Anu2657/Menstrual-Tracker/PHOTOS/IMG_20261025_213342273.jpg

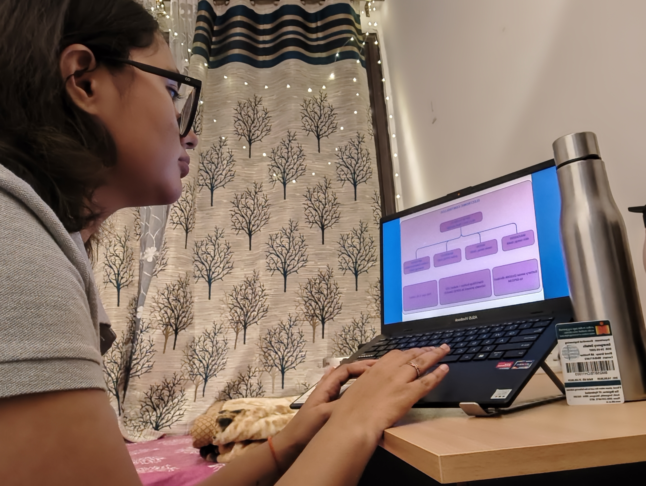
PHOTOS/IMG_20261025_213342273.jpg
