Anu2657/Menstrual-Tracker/README.md

# Menstrual-Tracker
Wearable device for menstrual cycle tracking-Vishwakarma Awards 26-27
