Anu2657/Menstrual-Tracker/PHOTOS/README.md

All pictures of work done including screenshots of the WIP CAD designing, (please include the places where difficulty is faced as well)
