Anu2657/Menstrual-Tracker/PHOTOS/Electronic Controller(1).png

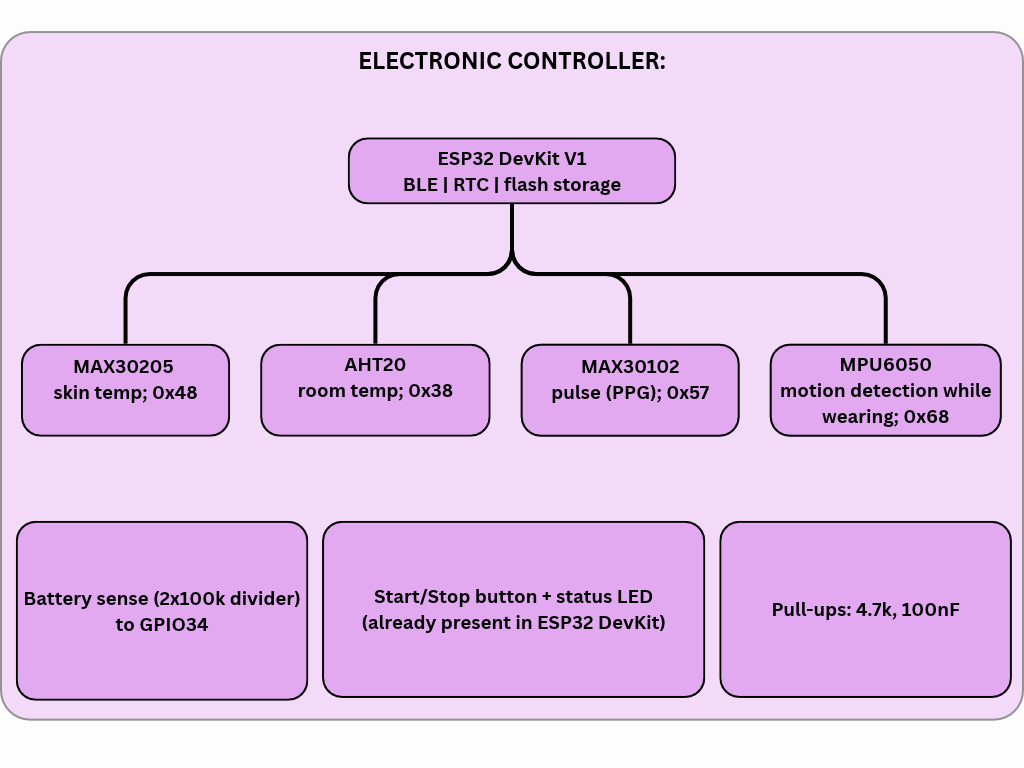
PHOTOS/Electronic Controller(1).png
