Anu2657/Menstrual-Tracker/PHOTOS/Labelled Exploded View .jpeg

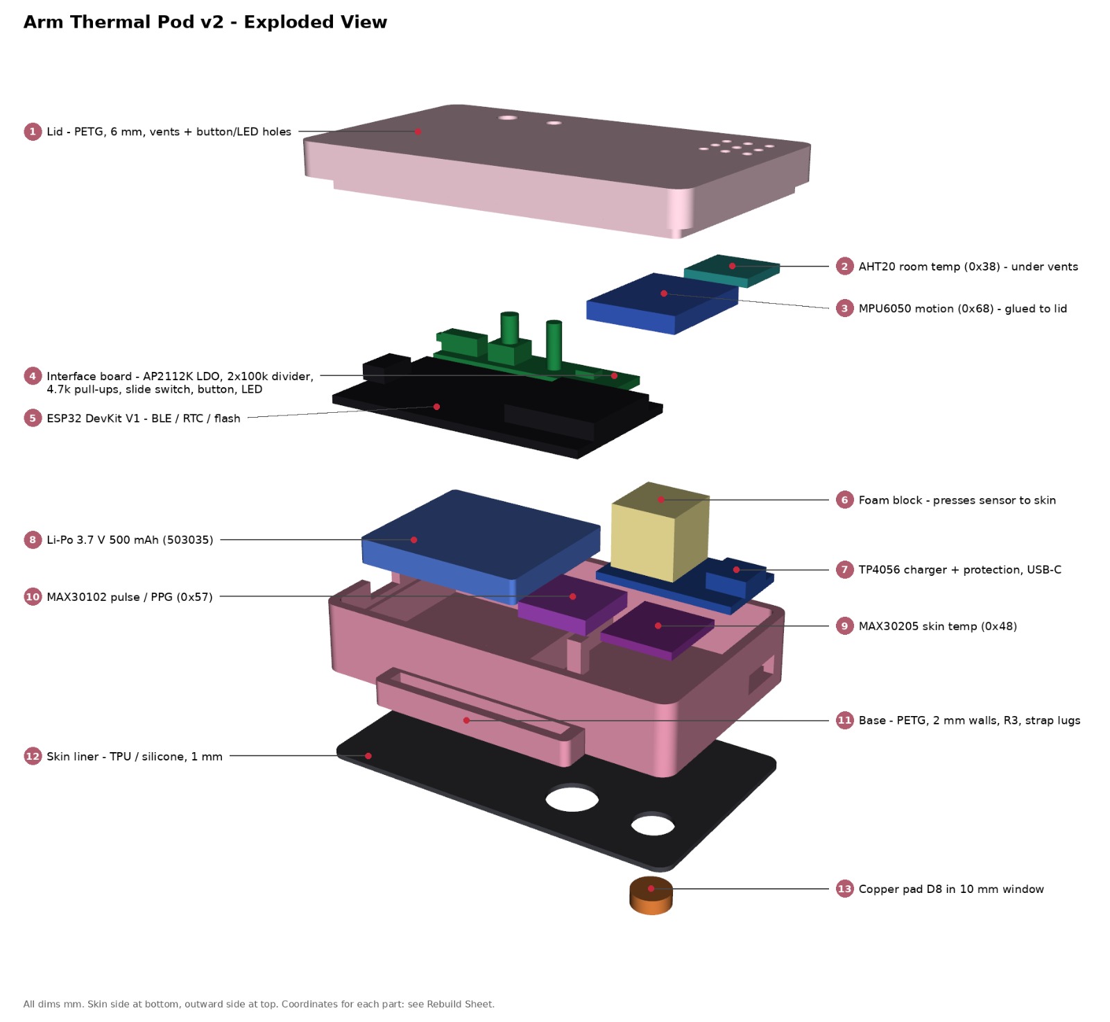
PHOTOS/Labelled Exploded View .jpeg
