Anu2657/Menstrual-Tracker/PHOTOS/Mechanical Structure(1).png

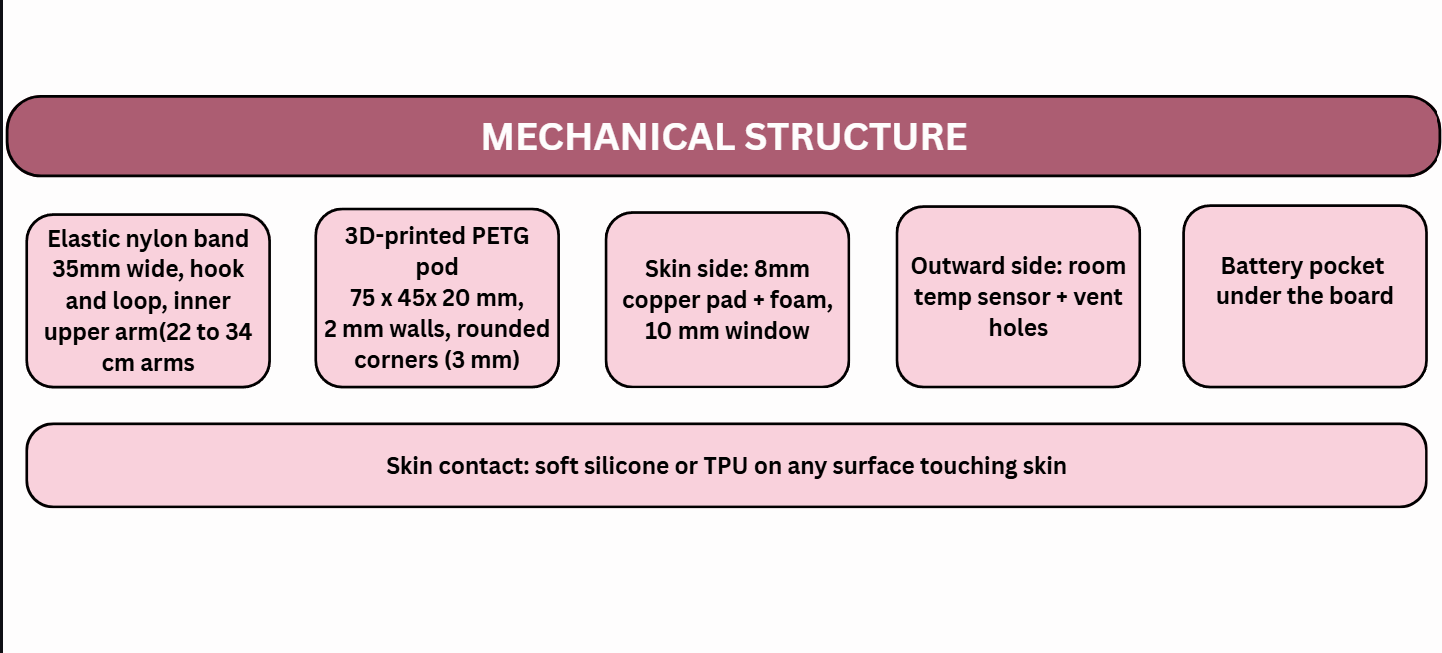
PHOTOS/Mechanical Structure(1).png
