Anu2657/Menstrual-Tracker/PHOTOS/Power.png

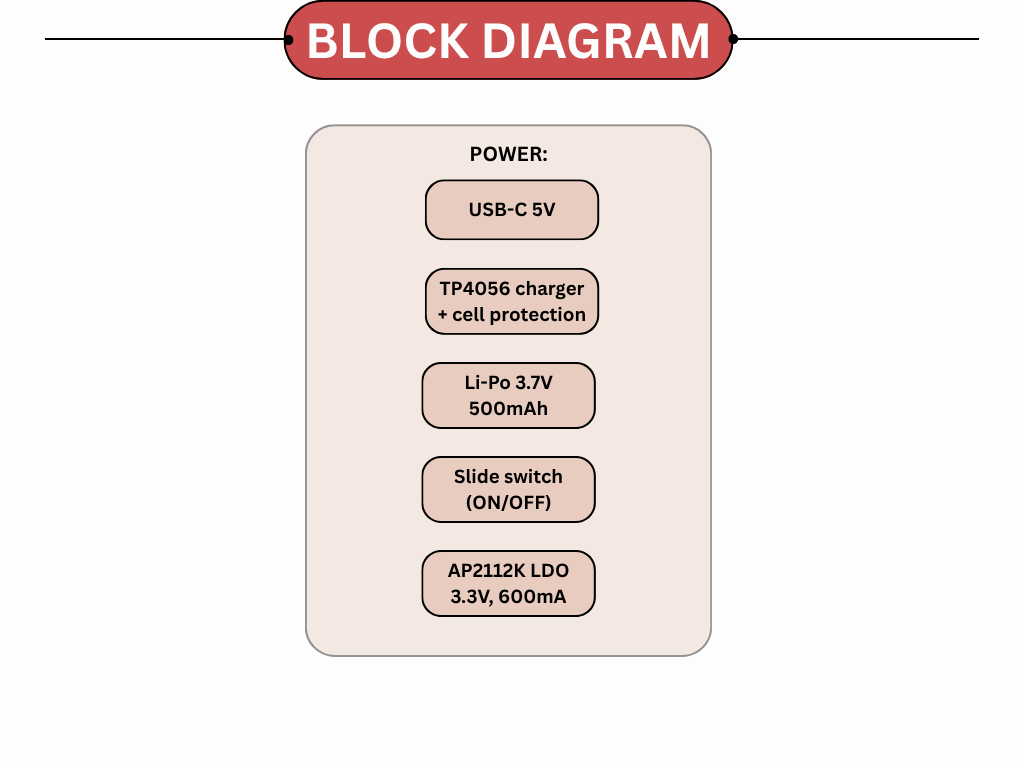
PHOTOS/Power.png
