Anu2657/Menstrual-Tracker/PHOTOS/Readings.png

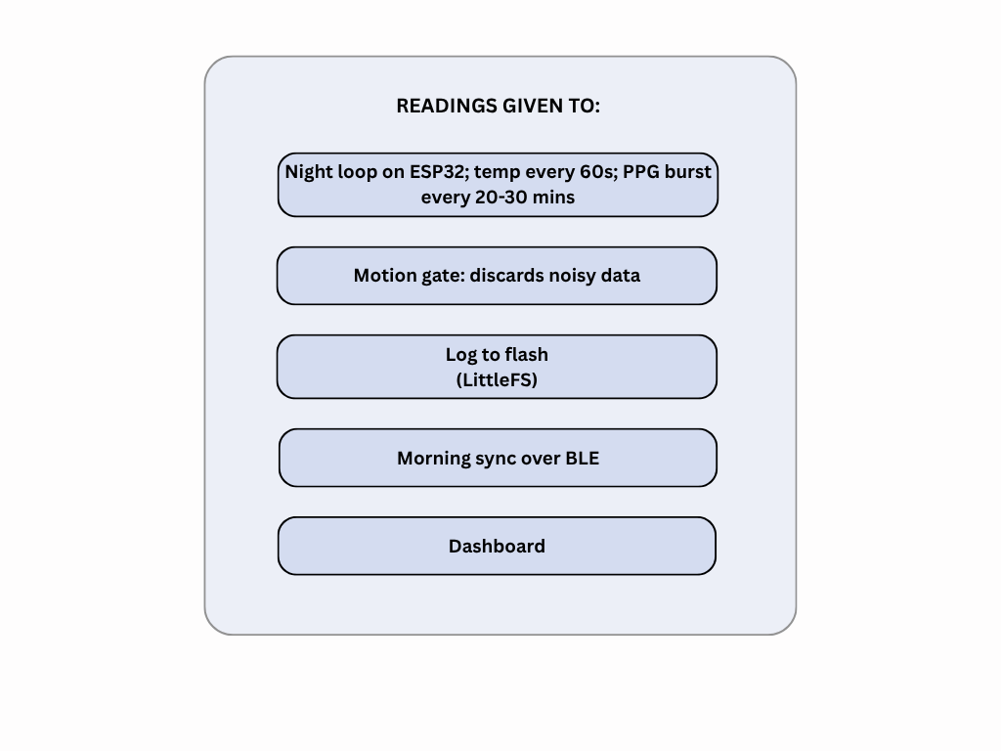
PHOTOS/Readings.png
