Anu2657/Menstrual-Tracker/SCHEMATICS/Block Diagram of Electric Schematic.png

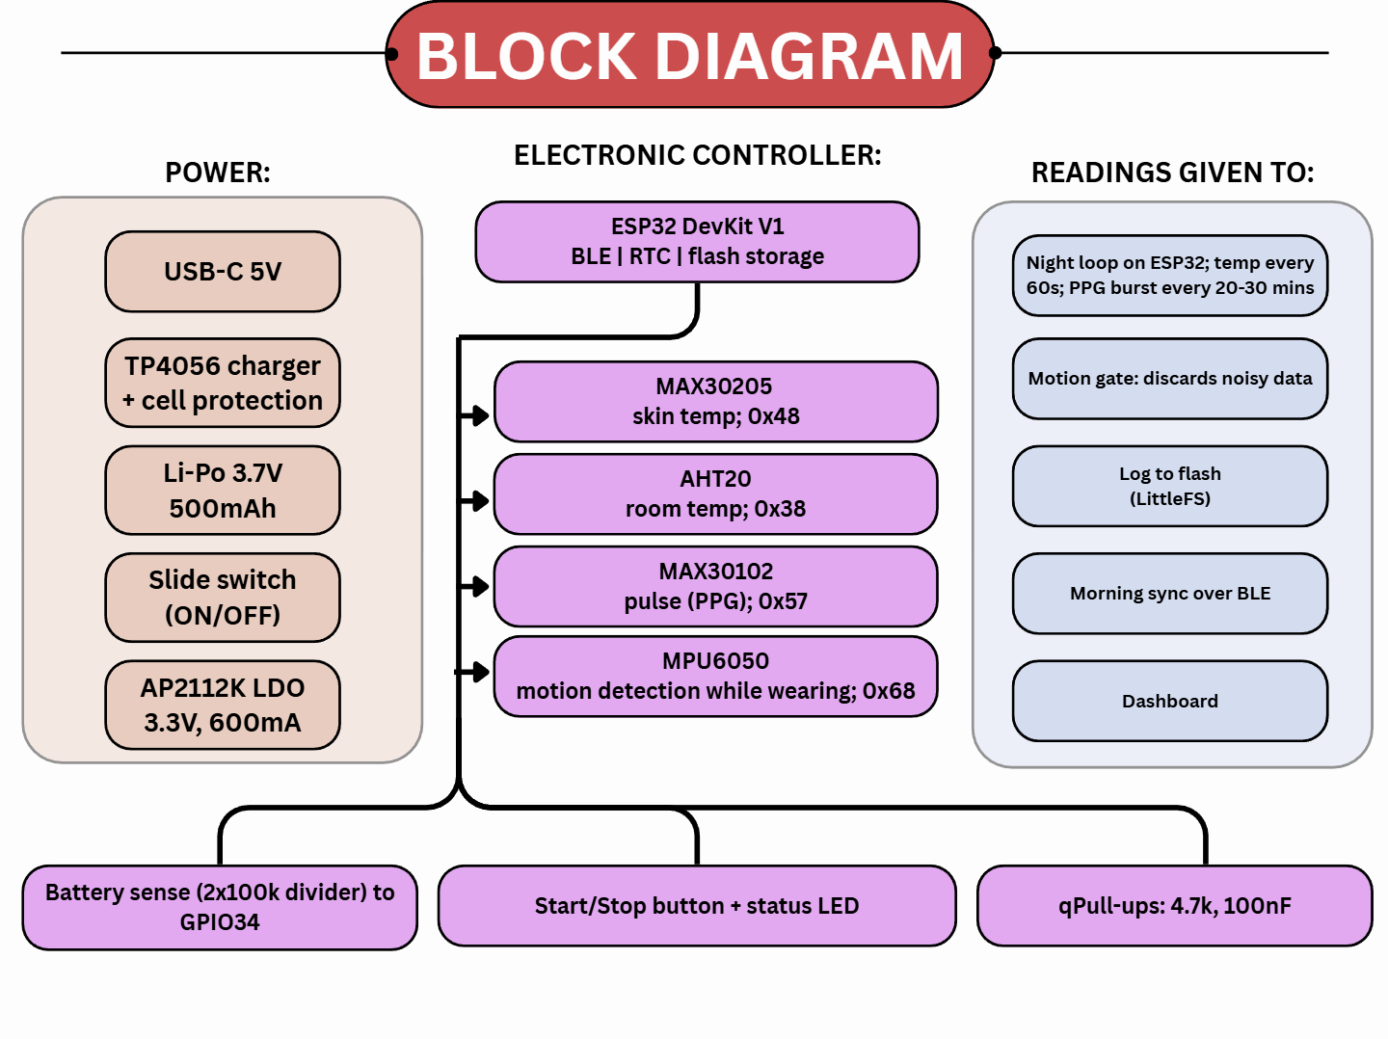
SCHEMATICS/Block Diagram of Electric Schematic.png
