Anu2657/Menstrual-Tracker/MATERIALS/README.md

Materials selection and mechanical specs to be uploaded here
