Anu2657/Menstrual-Tracker/MATERIALS/Specs and components.xlsx

Sheet: Target specs
Parameter | Target | Hardware
Logging | 8 h per night, at least 2 nights per charge (to verify) | 500 mAh LiPo
Skin temperature | 1 sample per minute, resolution 0.01 °C or better | MAX30205
Pulse bursts | 2 min every 20 to 30 min at 100 Hz | MAX30102
Motion and wear | 50 Hz accelerometer | MPU6050
Data per night | about 0.4 MB (16 bursts × 12,000 samples × 2 bytes, plus small logs) | ESP32 flash
Sync | Bluetooth each morning | ESP32
Mass | 80 g or less | Pod plus band

Sheet: Materials + Electrical componen
Component | Part | Qty | Must contain
Controller | ESP32 DevKit | 1 | Confirm it’s the classic ESP32-WROOM-32 based DevKit V1 (not an S2/S3/C3 variant) Has a USB port for programming (most do, but double-check it’s not a bare module requiring separate programming hardware)
Skin temp | MAX30205 module | 1 | Onboard pull-up resistors on SDA and SCL Onboard 0.1µF decoupling capacitor near the power pin A0/A1/A2 address pins clearly broken out or confirmed tied low (default address 0x49) Operates on 3.3V
Pulse | MAX30102 module | 1 | Onboard 1.8V regulator Onboard pull-up resistors on SDA/SCL (4.7kΩ typical) Important: confirm with the seller/listing that the pull-ups are wired to the module’s 3.3V rail, not the internal 1.8V rail Fixed address 0x57
Motion | MPU6050 | 1 | Onboard voltage regulator Onboard pull-up resistors on SDA/SCL AD0 pin tied to a defined level (not left floating) Default address 0x68
Room temp | AHT20 | 1 | Onboard 10K pull-up resistors on SDA/SCL Fixed address 0x38 Operates on 3.3V–5V
Charger | TP4056 with protection | 1 | Must be the “with protection” variant(this version adds the DW01A chip and a dual MOSFET, which guards the battery against overcharge, deep discharge, and short circuit. The basic TP4056 does NOT include any battery protection on its own) Has separate OUT+ / OUT− terminals (not just B+ / B−) (these are the protected output pins; the circuit must connect here, not directly to the raw battery terminals, for the protection to actually work) Input voltage USB-C (5V) input End-of-charge voltage 4.2V (this is standard for single-cell LiPo, just confirm it’s not a different battery chemistry’s charger)
Battery | LiPo 500 mAh | 1 | Must be a single-cell, 3.7V nominal LiPo Check whether it already has its own tiny protection circuit built into the battery pack itself (it must have) Has a standard JST connector (the small 2-pin plug)
Regulator | AP2112K-3.3 | 1 | Confirm it’s specifically the 3.3V output version (AP2112K is sold in multiple fixed-voltage versions: 3.3V, 2.5V, 1.8V, etc. so the exact part number suffix matters; something like “AP2112K-3.3” )
Passives, headers, switch | Mixed | set
Carrier PCB | Custom | 5
Band and print | Elastic, hook-and-loop, PETG | 1
