Anu2657/Menstrual-Tracker/BOM/BOM.xlsx

# | Component | Part | Qty | Key specs (datasheet values) | Unit price (INR) | Line total (INR)
1 | Controller | ESP32 DevKit (classic ESP32-WROOM-32, CP2102, USB-C) | 1 | ESP32-WROOM-32 module; dual-core Xtensa LX6 up to 240 MHz; 520 KB SRAM; 4 MB flash; Wi-Fi 802.11 b/g/n + Bluetooth 4.2/BLE; 3.3 V logic; 5 V via USB; CP2102 USB-to-UART bridge, USB-C. | 459 | 459
2 | Skin temp | MAX30205 module | 1 | Supply 2.7 to 3.3 V; accuracy +/-0.1 C only from 37 to 39 C; 16-bit resolution 0.00390625 C; ~600 uA typ supply current; range 0 to 50 C; I2C, 3 address pins (32 addresses); one-shot and shutdown modes; overtemperature output pin. | 750 | 750
3 | Pulse | MAX30102 module | 1 | Red 660 nm + IR 880 nm LEDs; 18-bit ADC; sample rate 50 to 3200 Hz; 32-sample FIFO; I2C address 0x57; interrupt pin; chip core 1.8 V + separate LED supply; module VIN about 3.3 V; <6 mA with LEDs off (module). | 130 | 130
4 | Motion | MPU6050 (GY-521 module) | 1 | 3-axis gyro (+/-250 to 2000 deg/s) + 3-axis accelerometer (+/-2, 4, 8, 16 g); 16-bit ADC; I2C 0x68 (AD0 low) or 0x69 (AD0 high); module supply 3 to 5 V via onboard LDO; 2.54 mm headers. | 150 | 150
5 | Room temp | AHT20 module | 1 | Temperature +/-0.3 C, humidity +/-2 %RH (ASAIR datasheet, not re-checked here); I2C fixed address 0x38; chip supply 2.0 to 5.5 V; module typically has onboard pull-ups. | 130 | 130
6 | Charger | TP4056 with protection, USB-C | 1 | Input 4.5 to 5.5 V (USB-C); TP4056 charger IC + DW01 protection; 1 A default charge current (set by PROG resistor); charging accuracy 1.5%; end-of-charge 4.2 V; cuts load below 2.4 V; short-circuit/over-current protection; red/green LEDs. | 45 | 45
7 | Battery | LiPo 3.7 V 500 mAh (503035 size, JST-PH 2-pin, with PCM) | 1 | Nominal 3.7 V, 4.2 V full, 500 mAh (~1.85 Wh); typical size 5 x 30 x 35 mm, ~10 g; built-in protection circuit (PCM); JST-PH 2.0 mm 2-pin lead. Charge at 0.5C (250 mA) or less. | 300 | 300
8 | Regulator | AP2112K-3.3 (SOT-23-5) | 1 | Fixed 3.3 V LDO; 600 mA output; dropout ~250 mV at 600 mA; input 2.5 to 6 V; ~55 uA quiescent; enable pin; SOT-23-5 | 30 | 30
9 | Regulator support | SOT-23-5 to DIP adapter board | 1 | Adapter so the SMD regulator can be used on a breadboard before the carrier PCB exists. | 15 | 15
10 | Passives | Resistor 100 kOhm | 2 | R3, R4: battery-voltage divider to GPIO34. 1/4 W, 1% . | 2 | 4
11 | Passives | Resistor 4.7 kOhm | 2 | R1, R2: I2C pull-ups on SDA and SCL. 1/4 W, 5% or better. | 2 | 4
12 | Passives | Capacitor 0.1 uF (100 nF) | 4 | C1 to C4: one decoupling capacitor each for MAX30205, AHT20, MAX30102, MPU6050. Modules already carry their own, so these are extra decoupling. | 3 | 12
13 | Passives | Capacitor 1 uF | 2 | C5, C6: AP2112K input and output. Ceramic, 10 V or higher; the AP2112K datasheet asks for 1 uF on both. | 4 | 8
14 | Switch | SPST slide switch | 1 | SW1: main power switch between battery + and the regulator input. Rated for at least 0.5 A at 5 V. | 10 | 10
15 | Headers | 2.54 mm male + female pin header strips | 1 | 2 x 1x19 female sockets for the 38-pin DevKit, plus male/female strips for the sensor modules | 40 | 40
16 | Connector | JST-PH 2-pin socket (to match battery) | 1 | 2.0 mm pitch; must match the battery plug | 15 | 15
17 | Prototyping | Breadboard + jumper wires | 1 | Half-size breadboard and male-to-female jumper pack | 150 | 150
18 | Carrier PCB | Custom 2-layer carrier board (KiCad design) | 5 | FR4, 1.6 mm, 2-layer; holds ESP32 DevKit and sensor modules on headers. Small runs are normally sold in 5s. | 300 | 1500
19 | Band | Elastic strap 35 mm + hook-and-loop | 1 | Nylon/spandex elastic, 35 mm wide, 22 to 34 cm adjustable length | 200 | 200
20 | Pod | PETG 3D print of casing (about 75 x 45 x 20 mm) | 1 | PETG, 2 mm walls, rounded corners | 400 | 400
21 | Skin contact | Copper disc 8 mm + foam + clear window | 1 | Thermal pad for skin-temp sensor, foam insulation, 10 mm clear optical window for the pulse sensor | 100 | 100
 | TOTAL (INR) |  |  |  |  | 4452
21
