Anu2657/Menstrual-Tracker/CAD/p1,11,12-asm1.stp

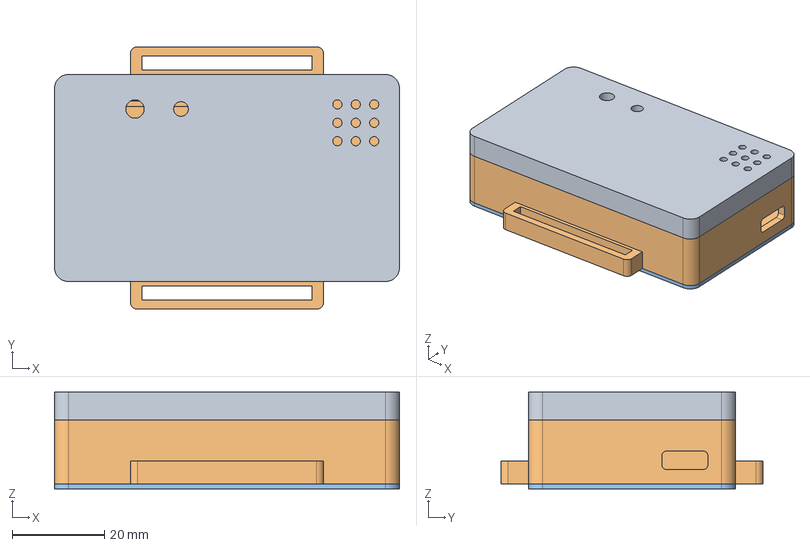
[picture p8: CAD file, 2026-10-23]
CAD/p1,11,12-asm1.stp
75.0 x 57.0 x 21.0 mm
part1_lid
part11_base
part12_skinliner
