Anu2657/Menstrual-Tracker/CAD/part11_base.stp

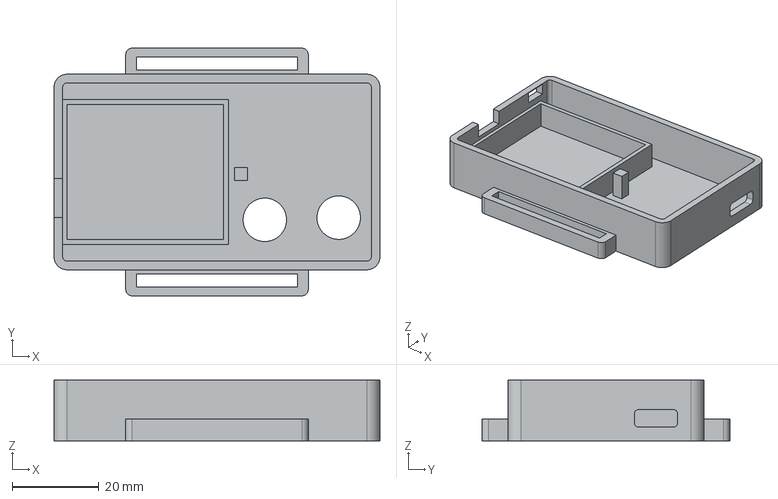
[picture p9: CAD file, 2026-10-23]
CAD/part11_base.stp
75.0 x 57.0 x 14.0 mm
