Anu2657/Menstrual-Tracker/CAD/part12_skinliner.stp

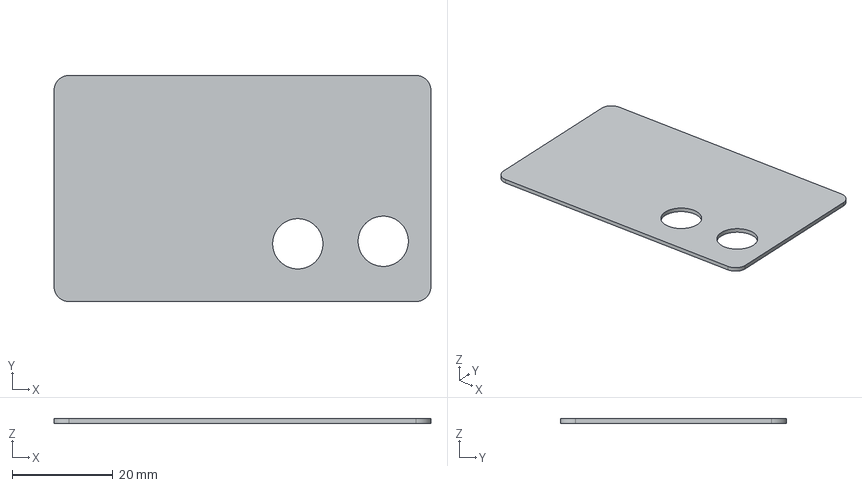
[picture p10: CAD file, 2026-10-23]
CAD/part12_skinliner.stp
75.0 x 45.0 x 1.00 mm
