Anu2657/Menstrual-Tracker/CAD/part1_lid.stp

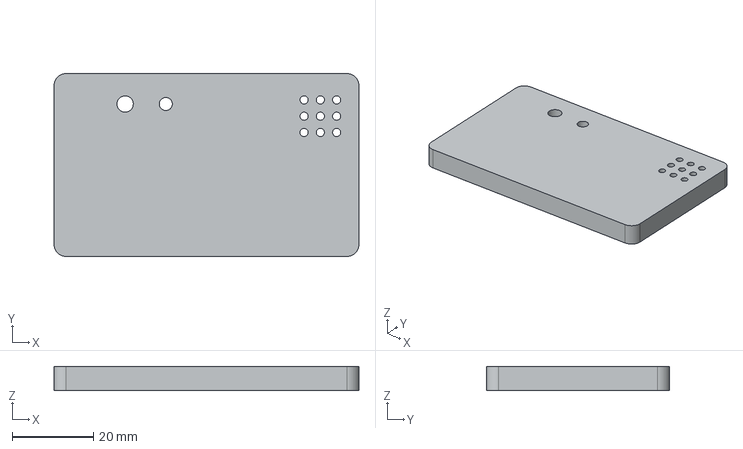
[picture p11: CAD file, 2026-10-23]
CAD/part1_lid.stp
75.0 x 45.0 x 6.00 mm
