Anu2657/Menstrual-Tracker/PHOTOS/assembly_bottom.png

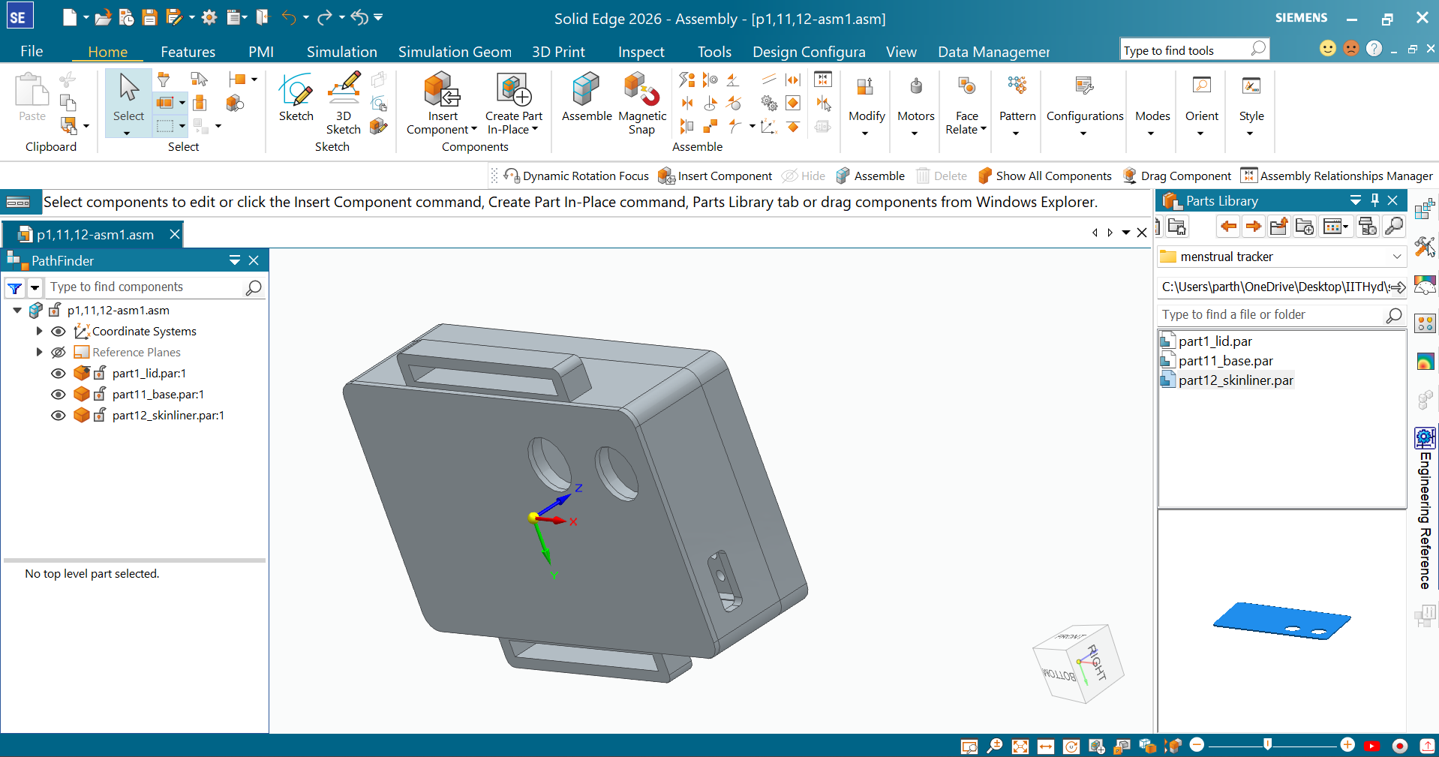
PHOTOS/assembly_bottom.png
