Anu2657/Menstrual-Tracker/PHOTOS/assembly_home.png

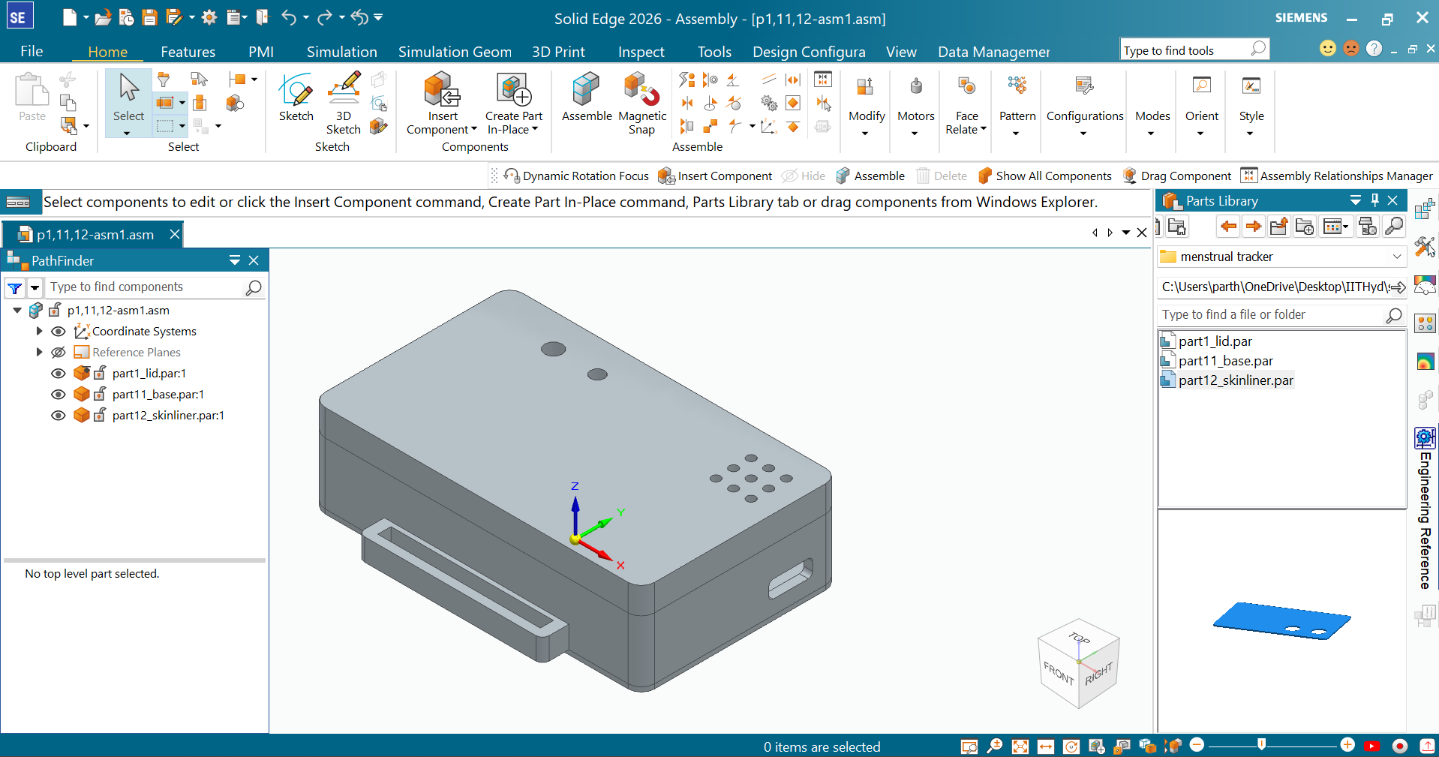
PHOTOS/assembly_home.png
