Anu2657/Menstrual-Tracker/PHOTOS/assembly_internal(no_lid).png

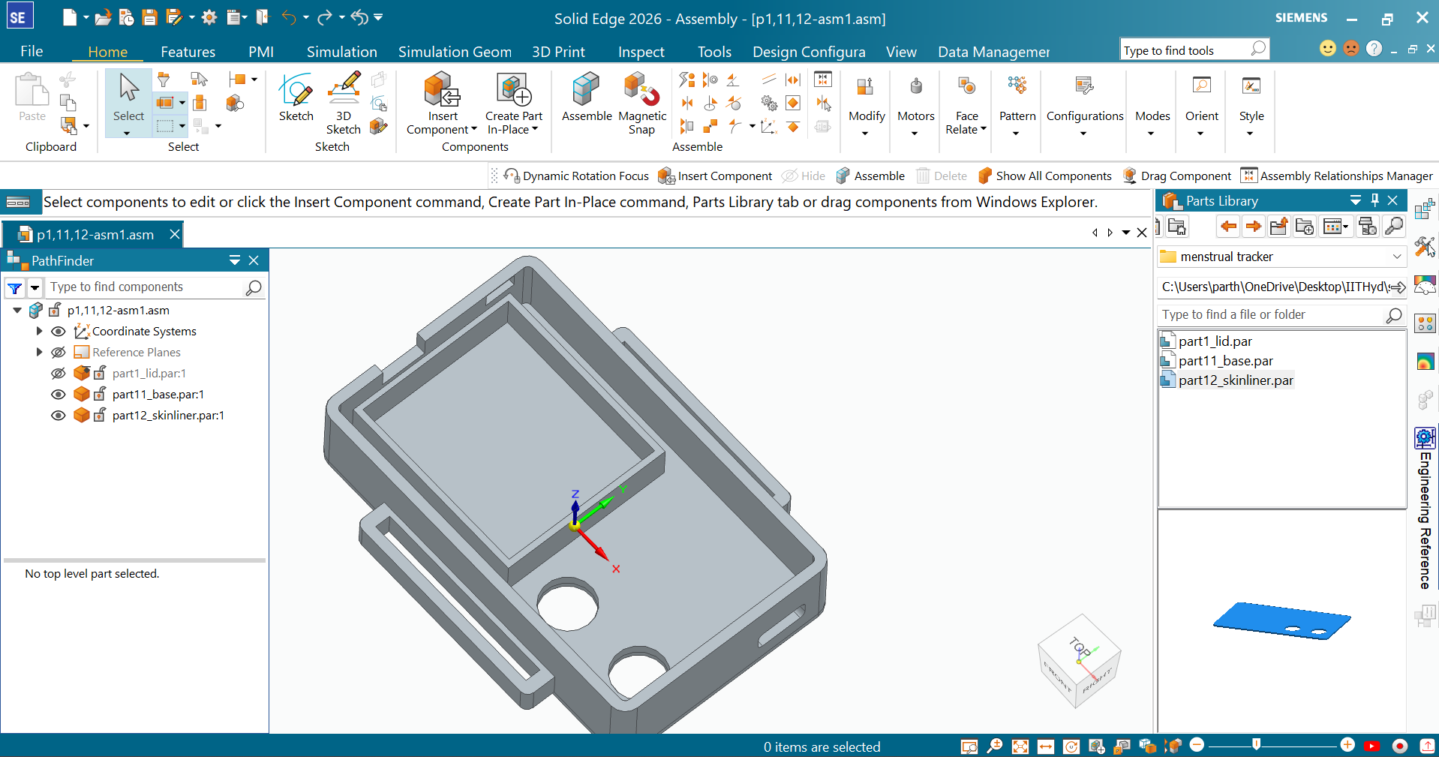
PHOTOS/assembly_internal(no_lid).png
