Anu2657/Menstrual-Tracker/Safety, FMEA, Standards compliance/README.md

add the safety measures in place, the failure analysis, and whether or not does our work meet the global guidelines over here
