Anu2657/Menstrual-Tracker/SCHEMATICS/KiCad cycle tracker.pdf

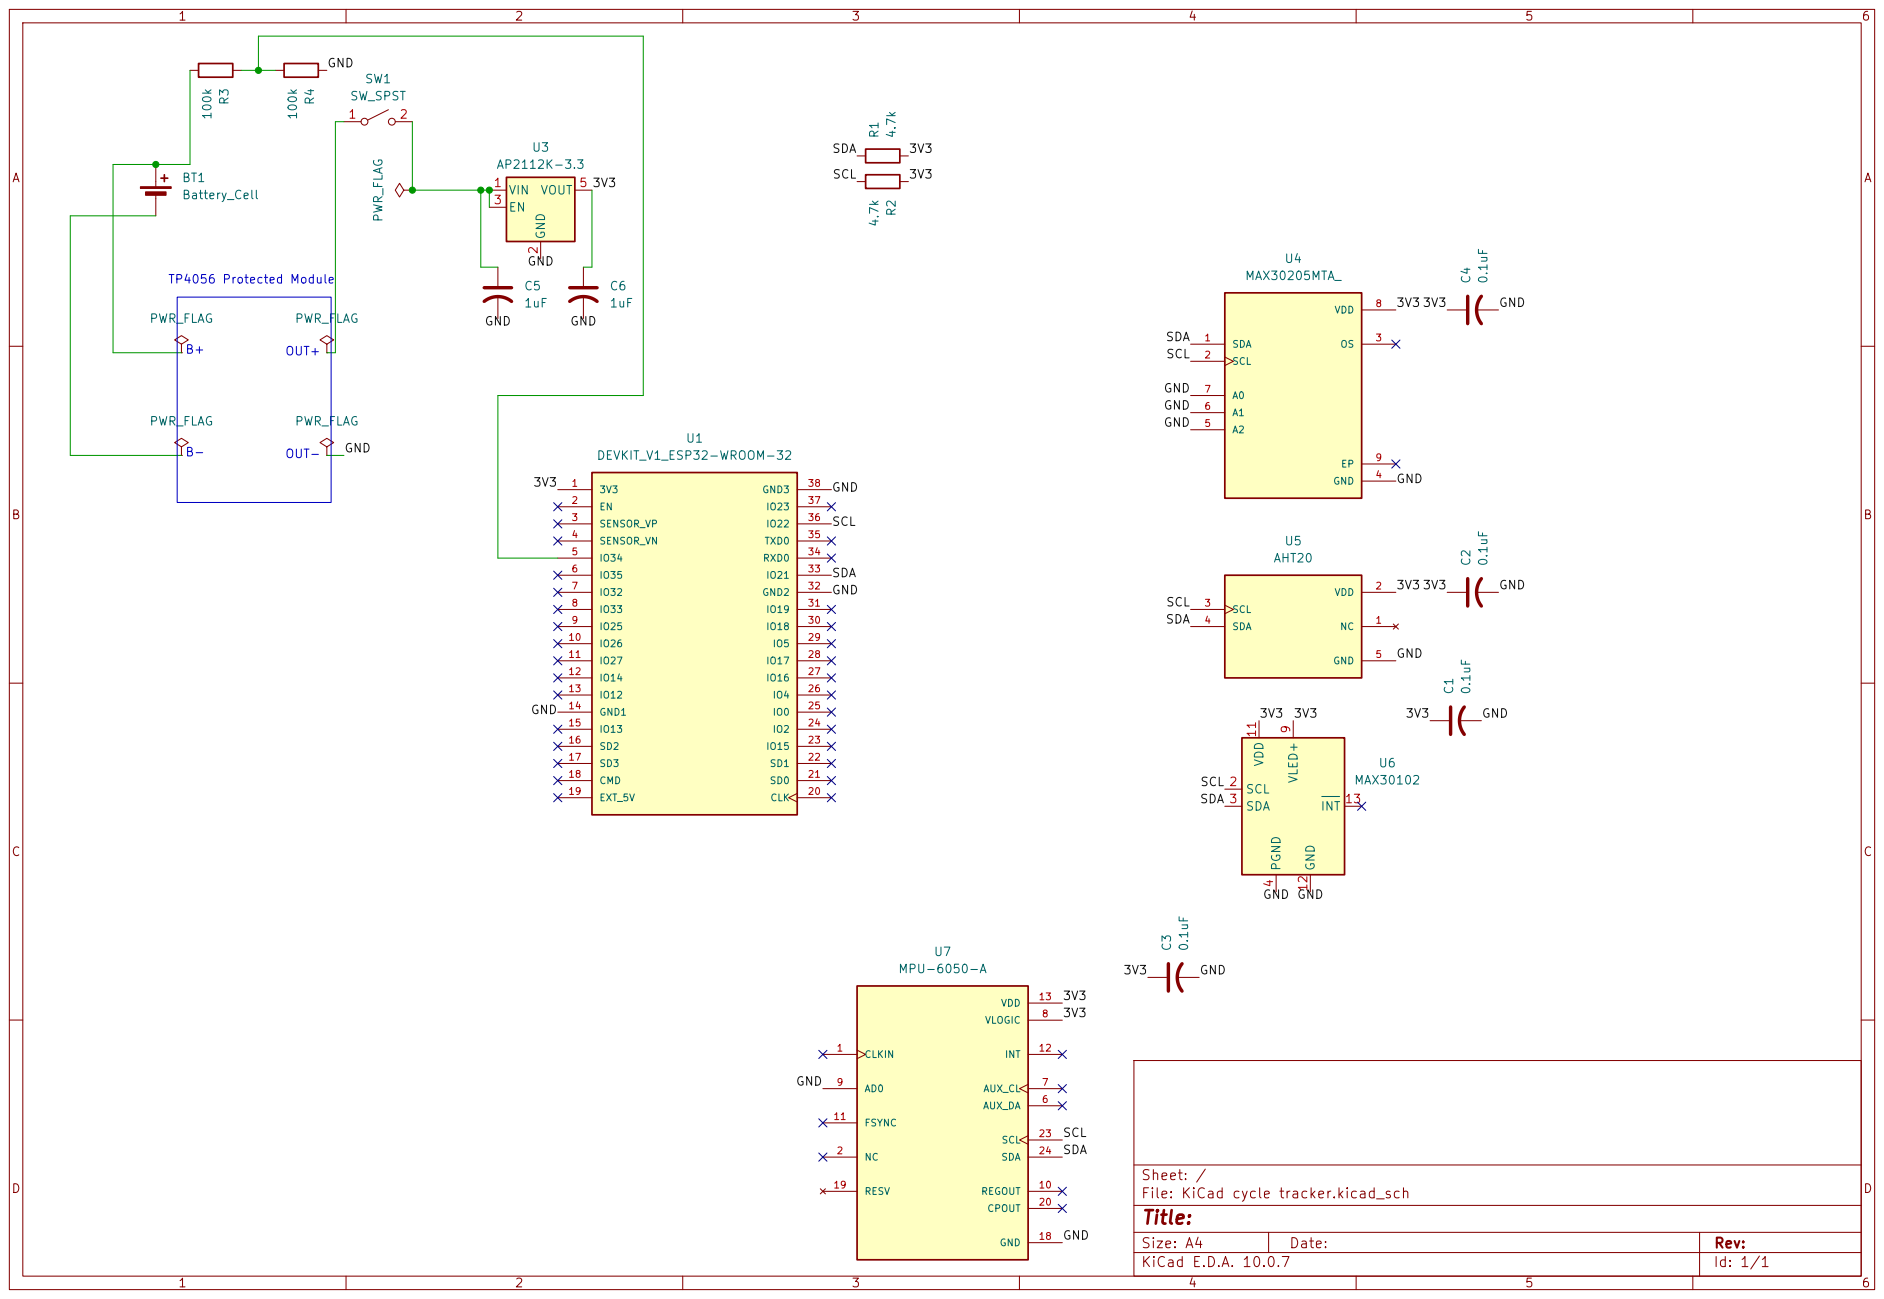
[picture p15: page 1]

Sheet: /
File: KiCad cycle tracker.kicad_sch
Title:

Size: A4 | Rev:
KiCad E.D.A. 10.0.7 | Id: 1/1
