Anu2657/Menstrual-Tracker/SCHEMATICS/KiCad cycle tracker.kicad_sch

## KiCad design SCHEMATICS/KiCad cycle tracker.kicad_sch (2026-10-25)

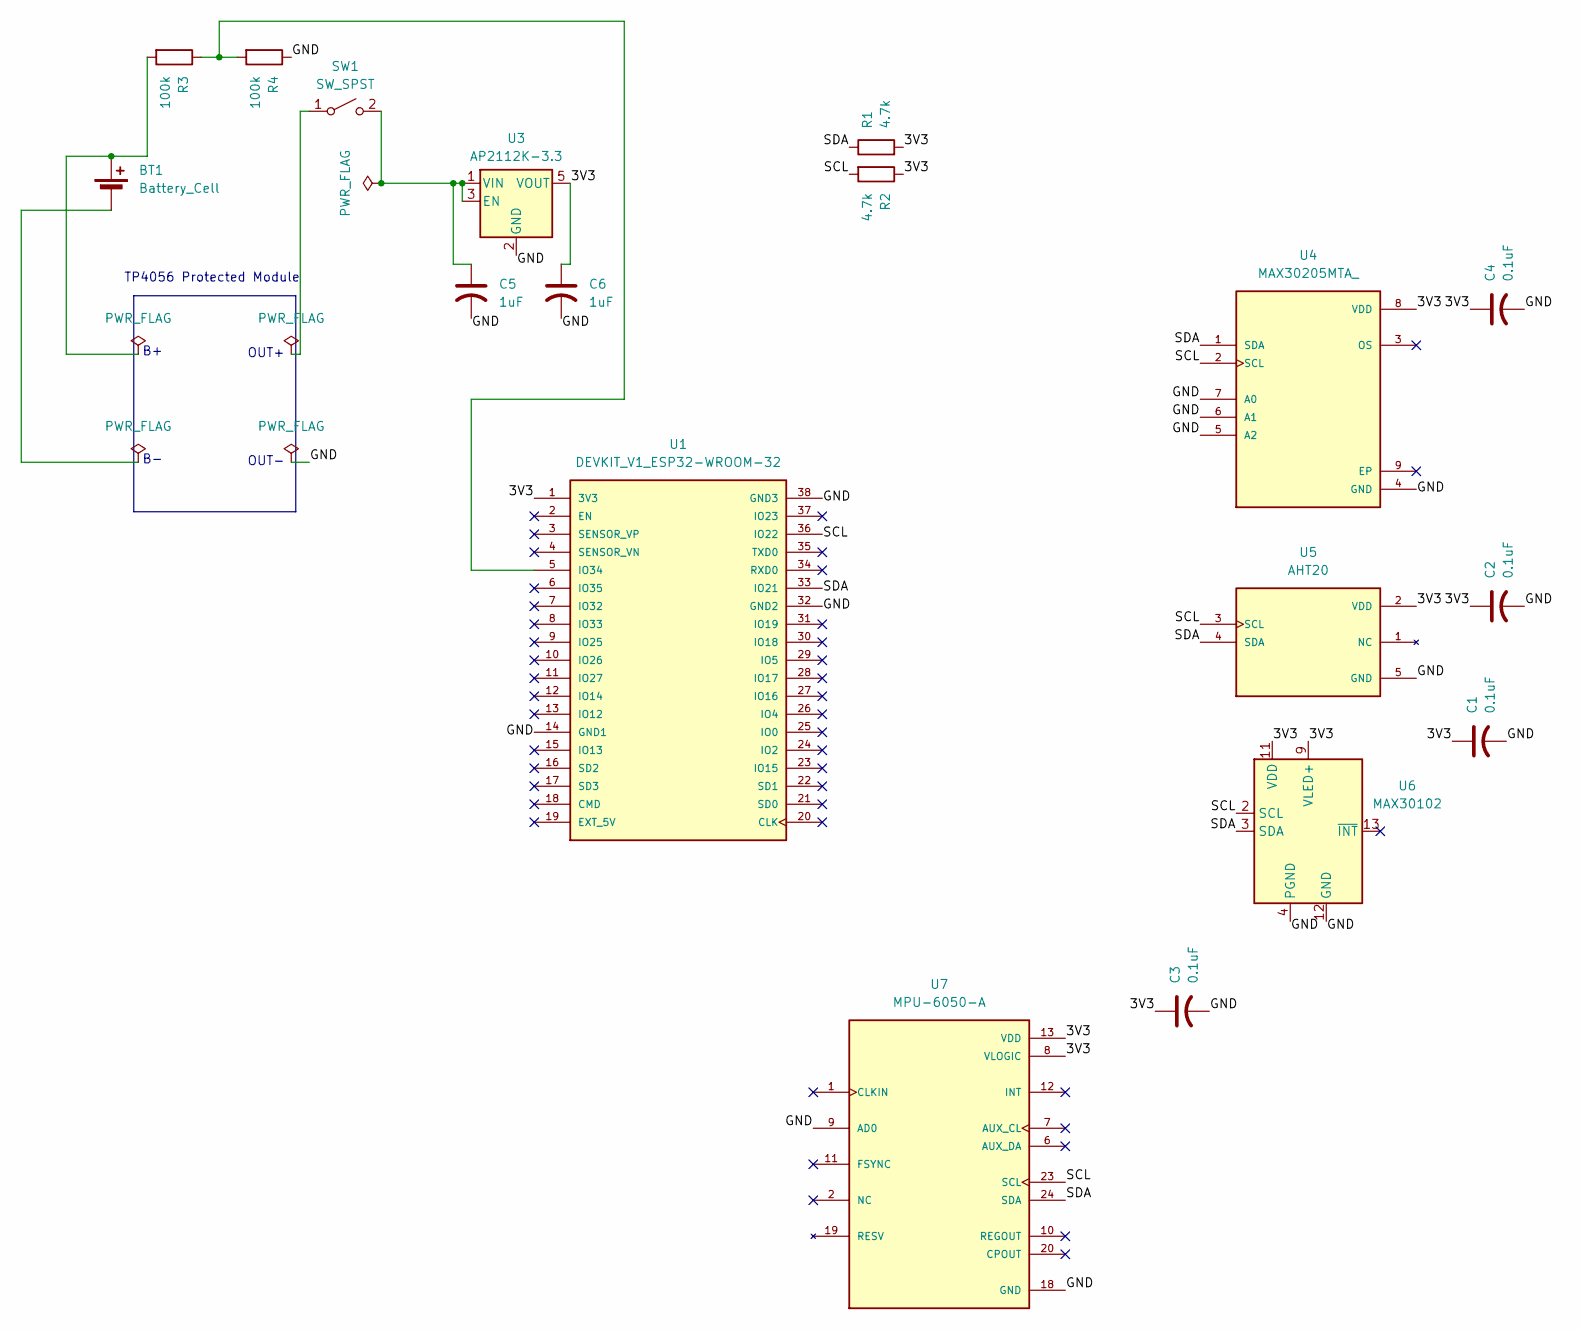
[picture p16: schematic KiCad cycle tracker.kicad_sch]

Parts:
BT1: Battery_Cell
C1, C2, C3, C4: 0.1uF
C5, C6: 1uF
R1, R2: 4.7k
R3, R4: 100k
SW1: SW_SPST
U1: DEVKIT_V1_ESP32-WROOM-32; MODULE_DEVKIT_V1_ESP32-WROOM-32; PARTREV N/A
U3: AP2112K-3.3; SOT-23-5
U4: MAX30205MTA_; SON65P300X300X80-9N
U5: AHT20; PSON100P300X300X110-6N; M_PART_NUMBER AHT20
U6: MAX30102; Maxim_OLGA-14_3.3x5.6mm_P0.8mm
U7: MPU-6050-A; QFN50P400X400X95-24N; PARTREV 3.4

Connections:
3V3: C1.1, C2.1, C3.1, C4.1, C6.1, R1.2, R2.1, U1.1 (3V3), U3.5 (VOUT), U4.8 (VDD), U5.2 (VDD), U6.9 (VLED+), U6.10 (VLED+), U6.11 (VDD), U7.8 (VLOGIC), U7.13 (VDD)
GND: C1.2, C2.2, C3.2, C4.2, C5.2, C6.2, R4.1, U1.14 (GND1), U1.32 (GND2), U1.38 (GND3), U3.2 (GND), U4.4 (GND), U4.5 (A2), U4.6 (A1), U4.7 (A0), U5.5 (GND), U6.4 (PGND), U6.12 (GND), U7.9 (AD0), U7.18 (GND)
unnamed: BT1.1 (+), R3.2
unnamed: C5.1, SW1.2 (B), U3.1 (VIN), U3.3 (EN)
unnamed: R3.1, R4.2, U1.5 (IO34)
unnamed: U5.1 (NC), U5.6 (NC)
unnamed: U7.2 (NC), U7.3 (NC), U7.4 (NC), U7.5 (NC), U7.14 (NC), U7.15 (NC), U7.16 (NC), U7.17 (NC)
unnamed: U7.19 (RESV), U7.21 (RESV), U7.22 (RESV)
SCL: R2.2, U1.36 (IO22), U4.2 (SCL), U5.3 (SCL), U6.2 (SCL), U7.23 (SCL)
SDA: R1.1, U1.33 (IO21), U4.1 (SDA), U5.4 (SDA), U6.3 (SDA), U7.24 (SDA)

Notes on the sheet:
TP4056 Protected Module
OUT-
OUT+
