Anu2657/Menstrual-Tracker/(commit log)

2026-10-18 Add initial README for CAD directory
2026-10-18 Add initial README for BOM project
2026-10-18 Add README for project photos and CAD designs
2026-10-18 Add initial README for materials selection
2026-10-22 Create CAD Model
2026-10-22 CAD Model progress 1
2026-10-22 CAD Model Exploded View Reference
2026-10-23 CAD Assembly Views
2026-10-23 Part 1, 11, 12 Assembly
2026-10-23 Uploaded STEP files for all parts and assembly
    [p1,11,12-asm1.stp, part11_base.stp, part12_skinliner.stp, part1_lid.stp]
2026-10-23 uploaded corrected CAD files
    [p1,11,12-asm1.stp, part11_base.stp]
2026-10-23 update pdf SCHEMATICS/KiCad cycle tracker.pdf
2026-10-24 Added correct updates schematic
2026-10-25 Added final BOM for the project
    [BOM.xlsx]
2026-10-25 updates correct schematic uploaded
    [KiCad cycle tracker.kicad_sch]
2026-10-25 Edited BOM uploaded
    [BOM.xlsx]
2026-10-25 Corrected schematics uploaded
    [KiCad cycle tracker.kicad_sch]
2026-10-25 corrected BOM uploaded
    [BOM.xlsx]
2026-10-25 corrected specs and components uploaded
    [Specs and components.xlsx]
